WorldWilderLab/PlanEt_SMD/kicad/Vocab-extended-BOM.csv

Reference | Value | Footprint | Datasheet | MFN | MFP
R4 | 100K | Resistors_SMD:R_0805
R3 | 100K | Resistors_SMD:R_0805
R2 | 100K | Resistors_SMD:R_0805
R1 | 100K | Resistors_SMD:R_0805
R12 | 10k | Resistors_SMD:R_0805
R13 | 10k | Resistors_SMD:R_0805
K1 | CONN_3 | Socket_Strips:Socket_Strip_Straight_1x03 |  | 640457-2 | TE Connectivity
K2 | CONN_3 | Socket_Strips:Socket_Strip_Straight_1x03 |  | 640457-2 | TE Connectivity
R11 | 1M | Resistors_SMD:R_0805
R10 | 1M | Resistors_SMD:R_0805
R9 | 1M | Resistors_SMD:R_0805
R7 | 1M | Resistors_SMD:R_0805
C2 | 100n | Capacitors_SMD:C_1210 |  | MC1210B104K201CT | Multicomp
C1 | 100n | Capacitors_SMD:C_1210 |  | MC1210B104K201CT | Multicomp
D1 | 1n4148 | Diodes_SMD:SOD-123 |  | 1n4148W | Vishay
D2 | 1n4148 | Diodes_SMD:SOD-123 |  | 1n4148W | Vishay
D3 | 1n4148 | Diodes_SMD:SOD-123 |  | 1n4148W | Vishay
D4 | 1n4148 | Diodes_SMD:SOD-123 |  | 1n4148W | Vishay
C3 | 10u | Capacitors_SMD:c_elec_5x5.8 |  | AVES106M35C12T-F | Dubilier
R6 | 100k | Resistors_SMD:R_0805
R8 | 1M | Resistors_SMD:R_0805
R5 | 10k | Resistors_SMD:R_0805
P1 | NF | Socket_Strips:Socket_Strip_Straight_1x01 |  | NF | NF
K4 | NF | Socket_Strips:Socket_Strip_Straight_1x03 |  | NF | NF
K3 | NF | Socket_Strips:Socket_Strip_Straight_1x03 |  | NF | NF
C4 | 10u | Capacitors_SMD:c_elec_5x5.8 |  | AVES106M35C12T-F | Dubilier
P4 | NF | Socket_Strips:Socket_Strip_Straight_1x01 |  | NF | NF
P5 | NF | Socket_Strips:Socket_Strip_Straight_1x01 |  | NF | NF
R15 | 10k | Resistors_SMD:R_0805
P6 | CONN_2 | Socket_Strips:Socket_Strip_Straight_2x01 |  | 640455-2 | TE Connectivity
P2 | NF | Socket_Strips:Socket_Strip_Straight_1x01
U1 | ADS1115 | Housings_SSOP:MSOP-10_3x3mm_Pitch0.5mm |  | ADS1115IDGST | TI
R14 | 10K | Resistors_SMD:R_0805
R17 | 10K | Resistors_SMD:R_0805
R18 | 10K | Resistors_SMD:R_0805
R16 | 10K | Resistors_SMD:R_0805
M1 | Arduino | Arduino:Arduino | DOCUMENTATION | NF | NF
L2 | FERRITE BEAD | Choke_SMD:Choke_SMD_1206_Standard |  | 2512061217Y5 | Fair-rite
L1 | FERRITE BEAD | Choke_SMD:Choke_SMD_1206_Standard |  | 2512061217Y5 | Fair-rite
U2 | 11aa02e48 | Housings_SOT-23_SOT-143_TSOT-6:SOT-23 |  | 11aa02e48-I/TT | Microchip
Additional parts
M1 |  | 8 pin longtail sil socket |  | SSA-108-W-T | Samtec
M1 |  | 8 pin longtail sil socket |  | SSA-108-W-T | Samtec
M1 |  | 6 pin longtail sil socket |  | SSA-106-W-T | Samtec
M1 |  | 10 pin longtail sil socket |  | SSA-110-W-T | Samtec
