WorldWilderLab/PlanEt_SMD/kicad/Vocab.pdf

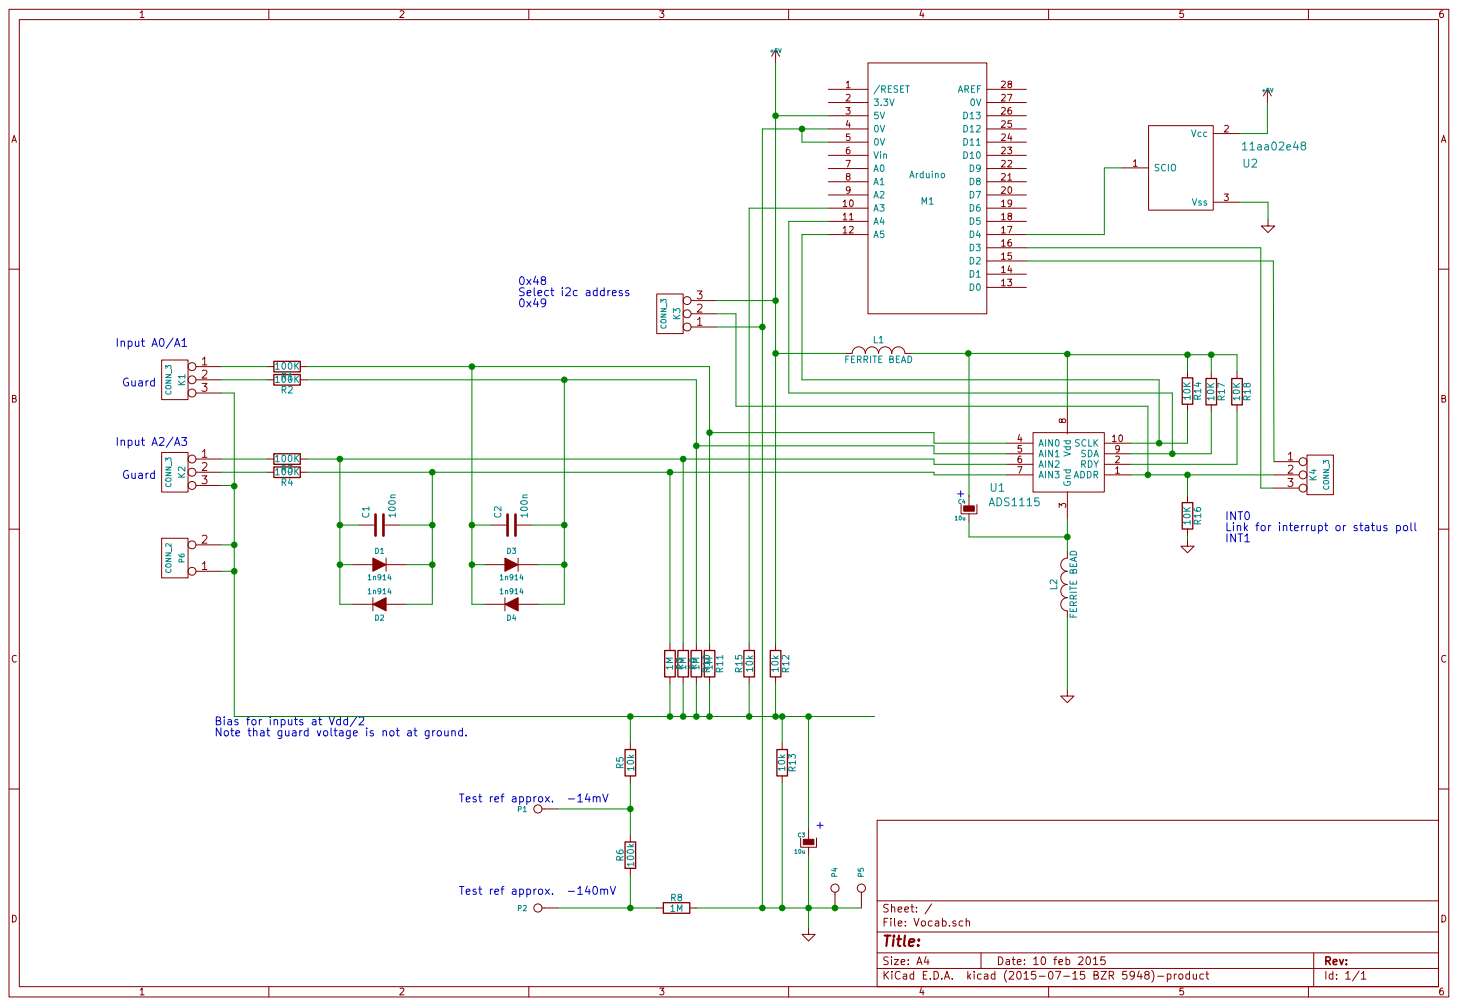
[picture p1: page 1]

Id: 1/1 Title: File: Vocab.sch Sheet: / R4

INT0
Link for interrupt or status poll INT1

Bias for inputs at Vdd/2
Note that guard voltage is not at ground.
