WorldWilderLab/PlanEt_SMD/kicad/Vocab-B_Cu.pdf

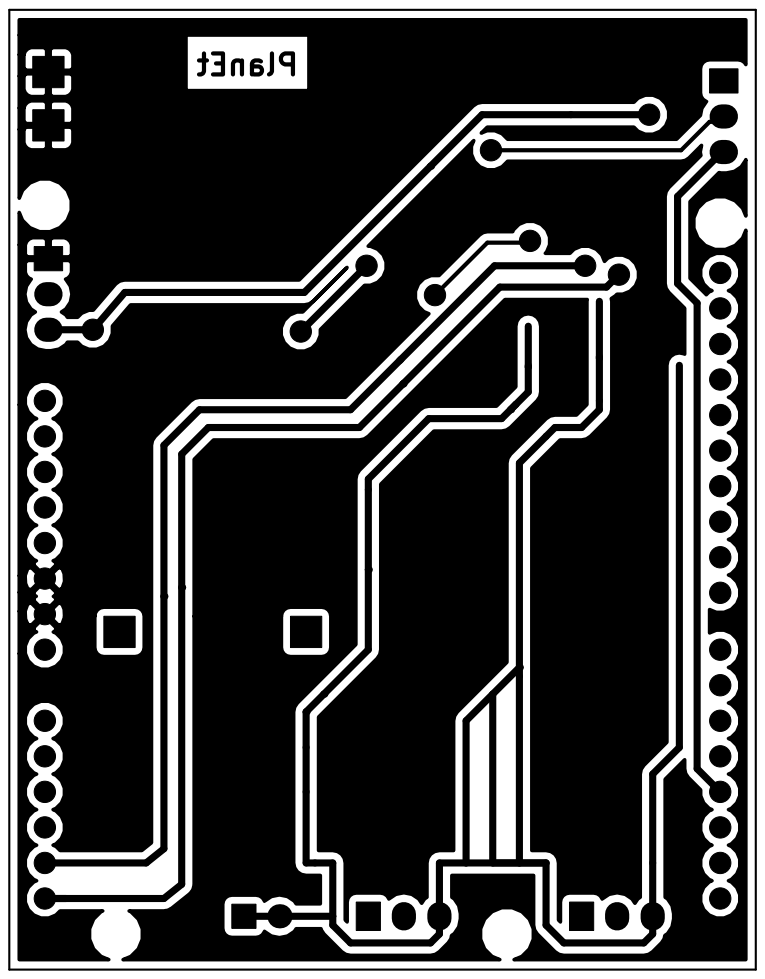
[picture p2: page 1]
