WorldWilderLab/PlanEt_SMD/kicad/Vocab-B_Mask.pdf

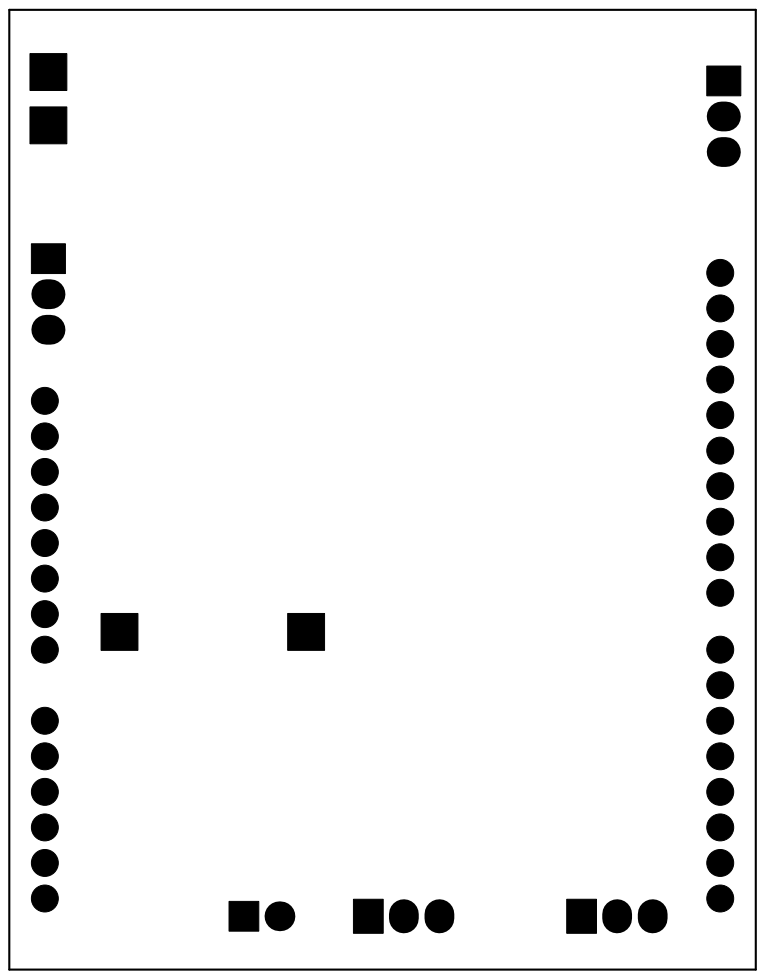
[picture p3: page 1]
