WorldWilderLab/PlanEt_SMD/kicad/Vocab-B_SilkS.pdf

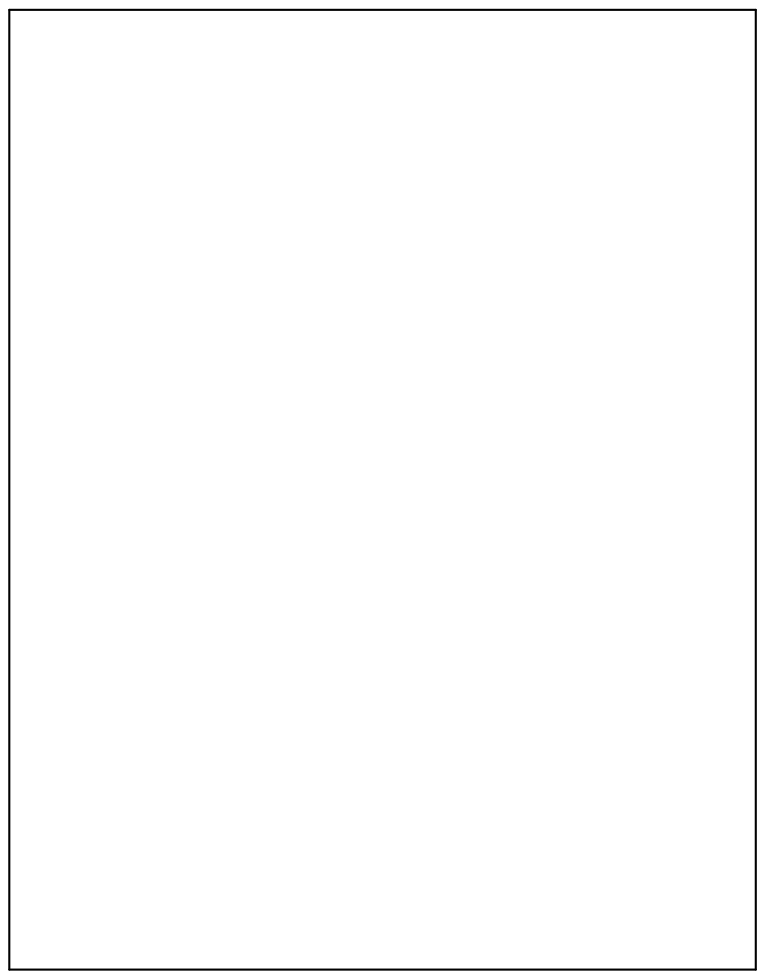
[picture p4: page 1]
