WorldWilderLab/PlanEt_SMD/kicad/Vocab-F_Cu.pdf

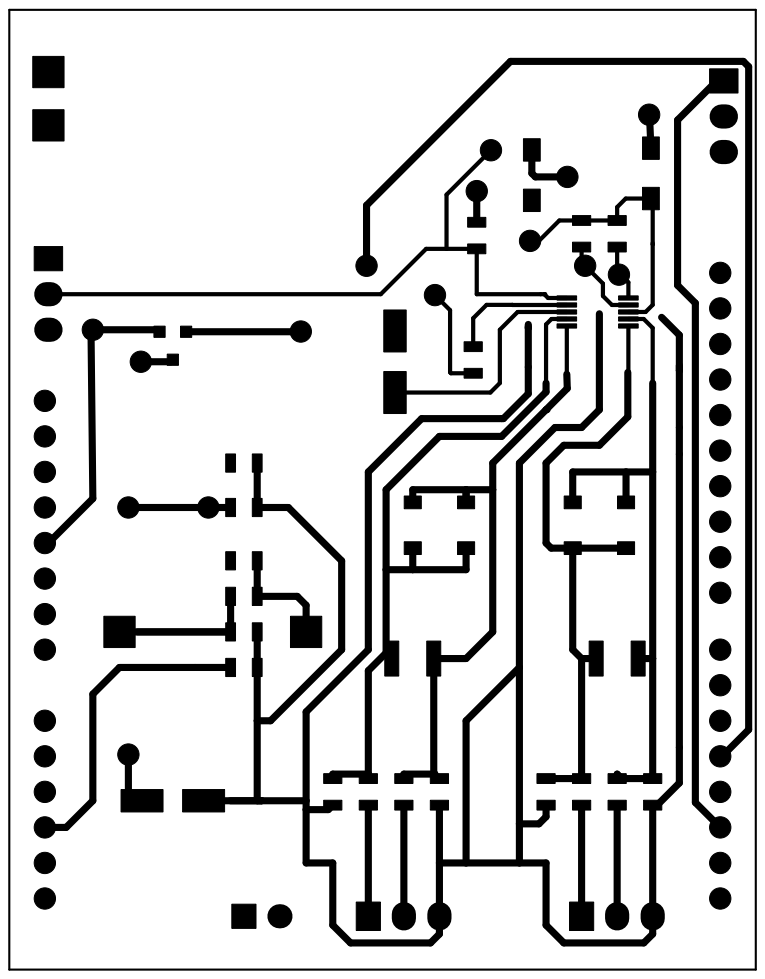
[picture p5: page 1]
