WorldWilderLab/PlanEt_SMD/kicad/Vocab-F_Mask.pdf

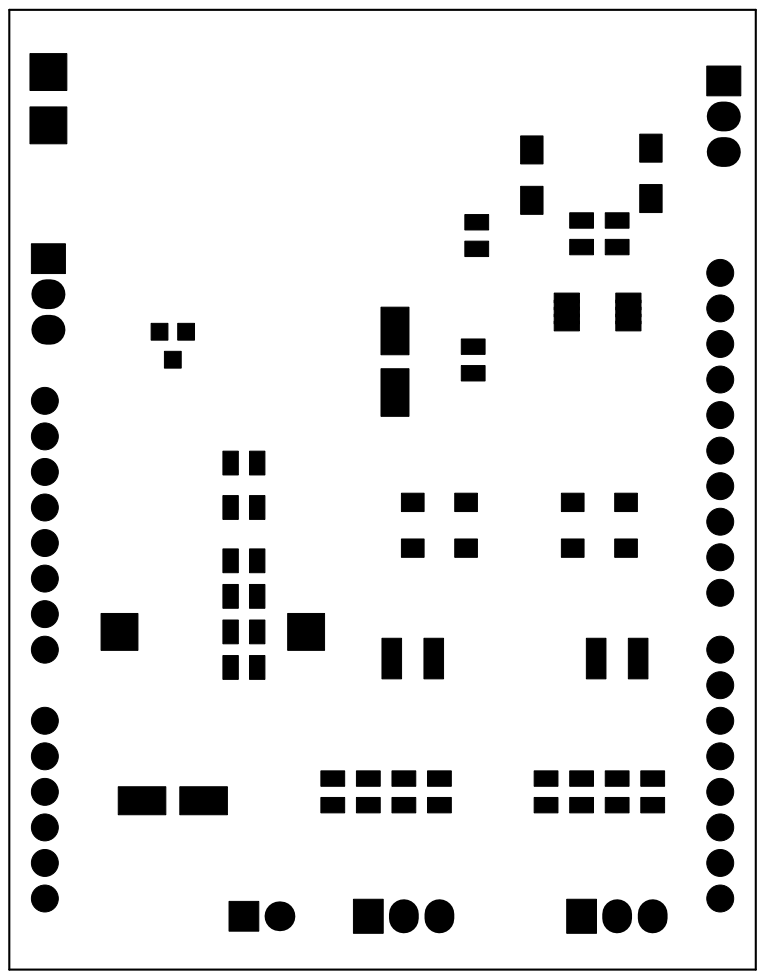
[picture p6: page 1]
