WorldWilderLab/PlanEt_SMD/kicad/Vocab-F_Paste.pdf

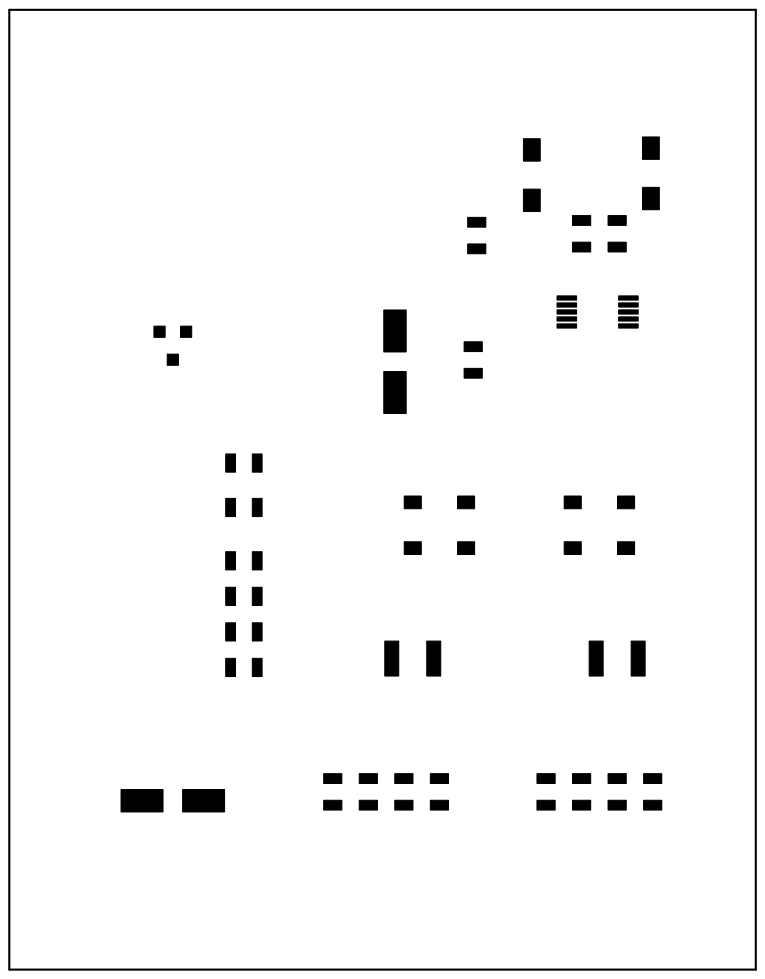
[picture p7: page 1]
