WorldWilderLab/PlanEt_SMD/kicad/Vocab-F_SilkS.pdf

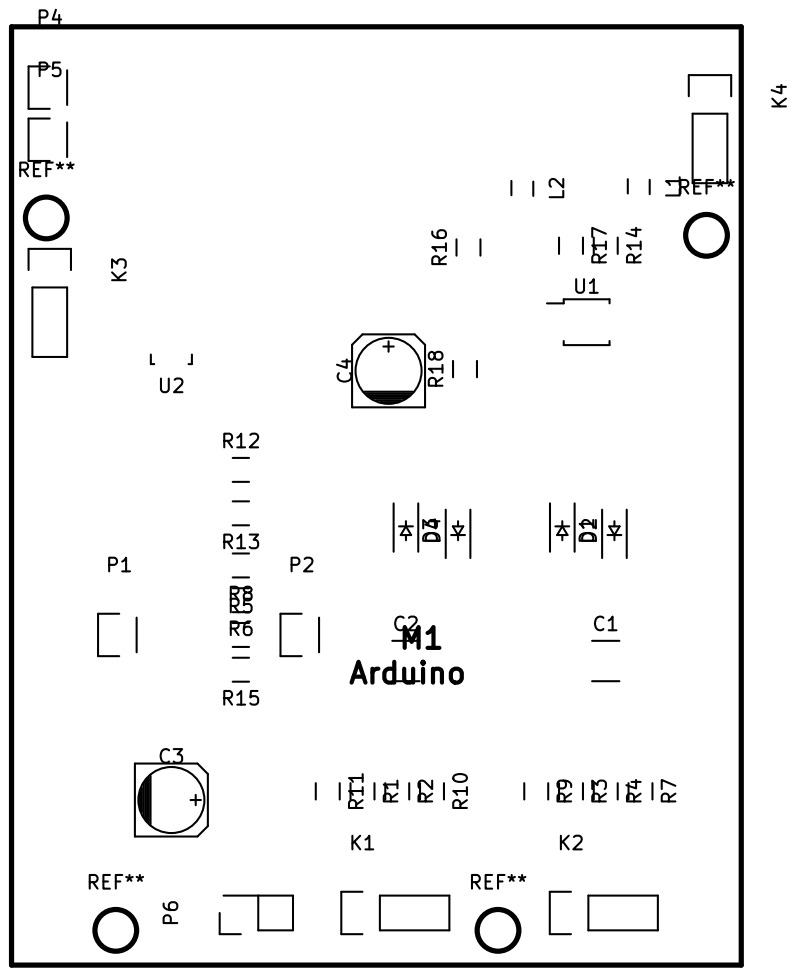
[picture p8: page 1]
