WorldWilderLab/PlanEt_SMD/kicad/Vocab.kicad_pcb

## KiCad design kicad/Vocab.kicad_pcb (2015-09-15)

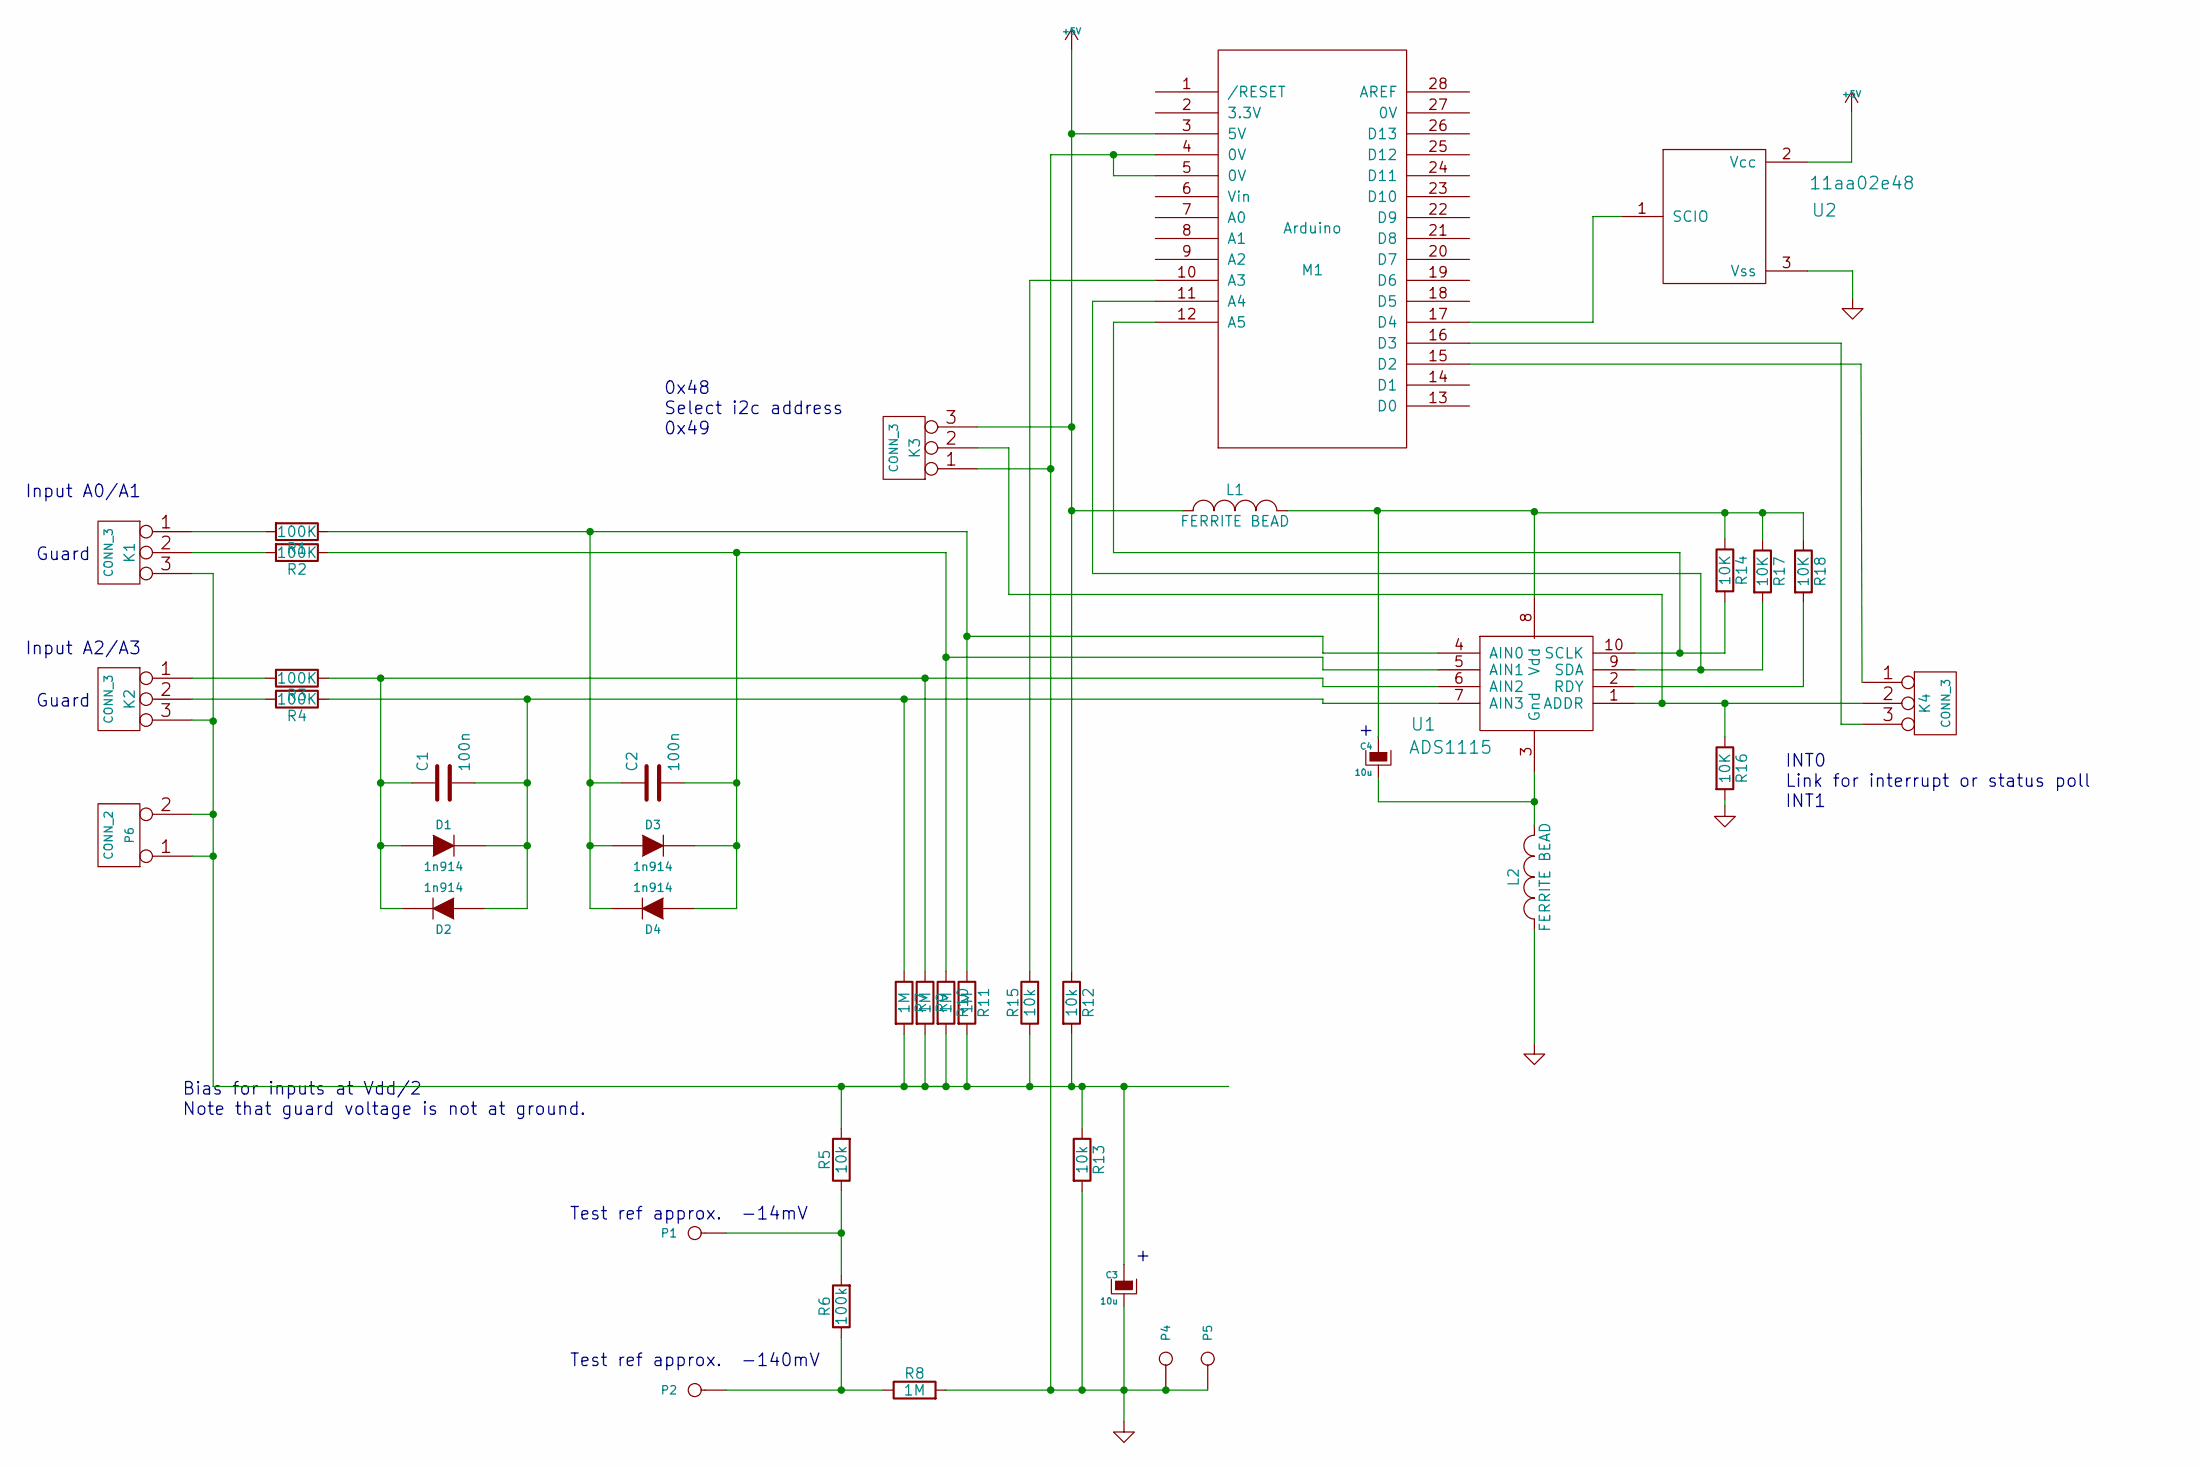
[picture p9: schematic Vocab.sch]

Parts:
C1, C2: 100n; C_1210
C3, C4: 10u; c_elec_5x5.8
D1, D2, D3, D4: 1n914; SOD-123
K1, K2, K3, K4: CONN_3; Socket_Strip_Straight_1x03
L1, L2: FERRITE BEAD; Choke_SMD_1206_Standard
M1: Arduino
P1, P2, P4, P5: CONN_1; Socket_Strip_Straight_1x01
P6: CONN_2; Socket_Strip_Straight_2x01
R1, R2, R3, R4: 100K; R_0805
R5, R12, R13, R15: 10k; R_0805
R6: 100k; R_0805
R7, R8, R9, R10, R11: 1M; R_0805
R14, R16, R17, R18: 10K; R_0805
U1: ADS1115; MSOP-10_3x3mm_Pitch0.5mm
U2: 11aa02e48; SOT-23

Connections:
+5V: K3.3, L1.1, M1.3 (5V), U2.2 (Vcc)
GND: C3.2, K3.1, L2.1, M1.4 (0V), M1.5 (0V), P4.1, P5.1, R13.2, R16.2, U2.3 (Vss)
unnamed: C1.1, D1.1 (A), D2.2 (K), R3.1, R9.1, U1.6 (AIN2)
unnamed: C1.2, D1.2 (K), D2.1 (A), R4.1, R7.1, U1.7 (AIN3)
unnamed: C2.1, D3.1 (A), D4.2 (K), R1.1, R11.1, U1.4 (AIN0)
unnamed: C2.2, D3.2 (K), D4.1 (A), R2.1, R10.1, U1.5 (AIN1)
unnamed: C3.1, K1.3, K2.3, P6.1, P6.2 (PM), R5.2, R7.2, R9.2, R10.2, R11.2, R12.2, R13.1, R15.1
unnamed: C4.2, U1.3 (Gnd)
unnamed: K1.1, R1.2
unnamed: K1.2 (PM), R2.2
unnamed: K2.1, R3.2
unnamed: K2.2 (PM), R4.2
unnamed: K3.2 (PM), K4.2 (PM), R16.1, U1.1 (ADDR)
unnamed: K4.1, M1.15 (D2)
unnamed: K4.3, M1.16 (D3)
unnamed: L1.2, R14.1, R17.1, R18.1, U1.8 (Vdd)
unnamed: M1.10 (A3), R15.2
unnamed: M1.11 (A4), R17.2, U1.9 (SDA)
unnamed: M1.12 (A5), R14.2, U1.10 (SCLK)
unnamed: M1.17 (D4), U2.1 (SCIO)
unnamed: P1.1, R5.1, R6.2
unnamed: P2.1, R6.1, R8.1
unnamed: R18.2, U1.2 (RDY)

Notes on the sheet:
Test ref approx. -140mV
Guard
Bias for inputs at Vdd/2 Note that guard voltage is not at ground.
Input A0/A1
Input A2/A3
Test ref approx. -14mV
INT0 Link for interrupt or status poll INT1
0x48 Select i2c address 0x49

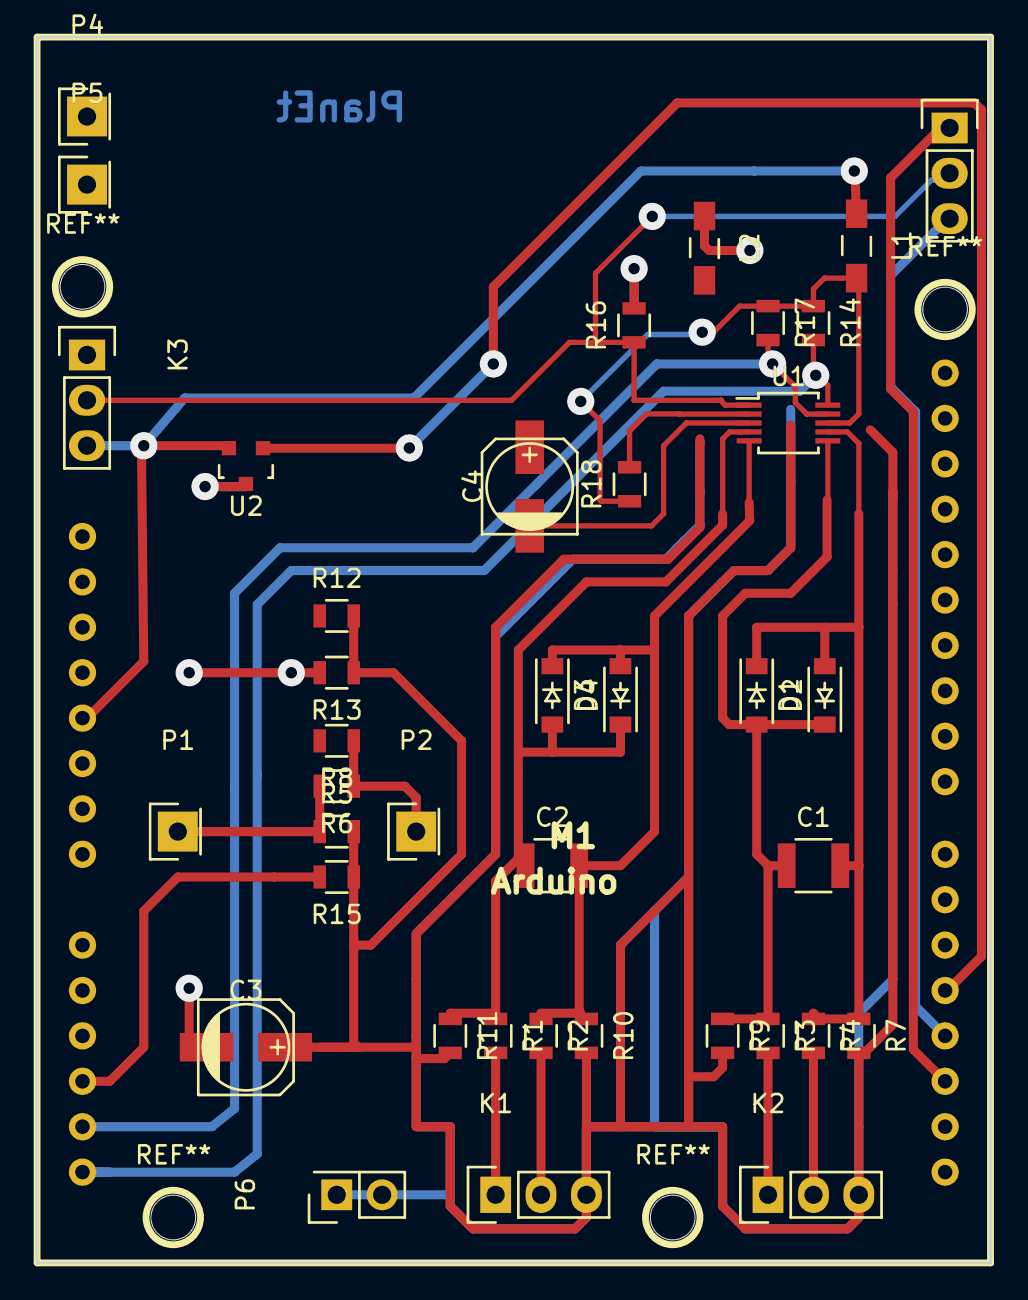
[picture p10: board Vocab.kicad_pcb from above]

Board: 2 copper layers, 53.3 x 68.6 mm, 40 parts (0 on the bottom side), 23 nets.
