WorldWilderLab/PlanEt_SMD/(threads)

Thread 1 (2015-09-15):

arduino firmware is still missing

lifthoofd, 2015-09-15:
the code for the arduino is not yet included

artag, 2015-09-15:
Code hasn't changed. We were going to discuss how we can split that work up
?

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

lifthoofd, 2015-09-15:
I could push it to this repo as well, it will be next on the things i have
to do. I thought to leave it like this until we have something that we can
put there.

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

--
tel: +31624144454
web: http://www.lifthoofd.nl
email: eovermeire@gmail.com

artag, 2015-09-15:
Push it anyway, it's the starting point for new work

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

lifthoofd, 2015-09-15:
Am pushing as we speak :)

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

--
tel: +31624144454
web: http://www.lifthoofd.nl
email: eovermeire@gmail.com

Closed 2015-09-15.

Thread 6 (2015-10-24):

wrong parts numbers in extended BOM

lifthoofd, 2015-10-24:
K1 and K2 have the 2 lead connectors as parts numbers, correct part number should be 640457-3

artag, 2015-10-28:
Correct, it should indeed be the -3 part.

http://uk.farnell.com/te-connectivity-amp/640457-3/header-right-angle-0-1-3way/dp/588726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

lifthoofd, 2015-10-28:
can you adjust the partlist in the repo so its correct on this point?

artag, 2015-10-28:
yes, I'll try to find out how I got it in there in the first place !

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

Thread 7 (2015-10-24):

C3 in extended BOM is only available in bulk quantities

lifthoofd, 2015-10-24:
minimum amounts range from 1000 to 3000, for our purposes its better if we have an alternative that can be bought in small quantities

artag, 2015-10-28:
The substitute that farnell offer is OK :

http://uk.farnell.com/multicomp/mcesl35v106m5x5-2/cap-alu-elec-10uf-35v-smd/dp/1870621

In fact, the component is not critical. Any 5mm diameter 10uF 10V + (eg 25V, 35V) will do.

http://uk.farnell.com/webapp/wcs/stores/servlet/Search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,110119879,110130369,110183885

lifthoofd, 2015-10-28:
ok! shall we change the part number in the partlist in the repo? or would it be better to leave the other partnumber?

artag, 2015-10-28:
I would change it in the bom.csv, but I tried to do that yesterday and
couldn't find where it was set ! So I'd just put it in the shopping list
for now as an equivalent. It's not wrong, as such. I'm not sure that
suppliers are really part of the schematic design.

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

lifthoofd, 2015-10-28:
ok, yeah my main concern is not as much suppliers but people that might be interested in making one for themselves. But lets leave it for now as is.

artag, 2015-10-28:
But you can't really keep a list of suppliers part numbers up to date. The
part spec (value and footprint) ought to be enough.

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

lifthoofd, 2015-10-28:
ok, fair enough!

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

--
tel: +31624144454
web: http://www.lifthoofd.nl
email: eovermeire@gmail.com

Thread 8 (2015-10-28):

Stacking headers

artag, 2015-10-28:
The stacking pin headers noted in the BOM are not ideal - apparently they are slightly too thick to stack correctly. They are also a little on the short sice - it may be necessary to stack two sets if an ethernet connector is underneath.

http://www.iheartrobotics.com/2009/04/arduino-stacking-headers.html

ESQ-108-14-T-S
ESQ-106-14-T-S

These have a 12mm spill as shown in http://cloud.samtec.com/catalog_english/esq_TH.pdf  (-14 lead style) but genuine arduino ethernet shields have a 16mm spill which might be better still. I haven't found a stockist for these.

Farnell do not stock these parts, but they can be obtained direct from Samtec or from Sparkfun as described above.

https://www.sparkfun.com/products/11417

There is also an older set which suits the earlier boards, containing 2 x 6 pin and 2 x 8 pin headers. The extra connections are not used by the PlanEt so this may be substituted, but will not then bring up the extra pins for further stacked boards.

https://www.sparkfun.com/products/10007

I have also obtained bags of this type of header from ebay more cheaply

http://www.ebay.co.uk/itm/High-quality-80pcs-40x8Pin-40x6Pin-Stackable-Female-Shield-Headers-for-Arduino-/230793327893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

lifthoofd, 2015-10-28:
I have always been using these:
* [https://www.kiwi-electronics.nl/arduino-platform/arduino-accessories/arduino-14-5mm-strip-10-weg-2-stuks](https://www.kiwi-electronics.nl/arduino-platform/arduino-accessories/arduino-14-5mm-strip-10-weg-2-stuks)
* [https://www.kiwi-electronics.nl/arduino-platform/arduino-accessories/arduino-14-5mm-strip-6-weg-2-stuks](https://www.kiwi-electronics.nl/arduino-platform/arduino-accessories/arduino-14-5mm-strip-6-weg-2-stuks)
* [https://www.kiwi-electronics.nl/arduino-platform/arduino-accessories/arduino-14-5mm-strip-8-weg-2-stuks](https://www.kiwi-electronics.nl/arduino-platform/arduino-accessories/arduino-14-5mm-strip-8-weg-2-stuks)

But they seem to be quite expensive...

artag, 2015-10-28:
Any are fine, though there are subtle differences in length. The one most
likely to be available long-term are also expensive, because they're doing
the work of finding new equivalent sources when another dries up.

The ebay ones are cheapest because they could be gone next month (in fact I
couldn't find the US supplier I used last time, yet there are suddenly a
bunch of chinese suppliers I hadn't found before).

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
