WorldWilderLab/PlanEt_SMD/(commit log)

2015-09-15 added arduino files
2015-10-06 Added manufacturer part numbers (except for Rs - generic 0805) Added stacking connectors to bom manually
    [Vocab-extended-BOM.csv, Vocab.csv, Vocab.sch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]
